brysonjk/o2_Analyzer/renders/battery_latch.png

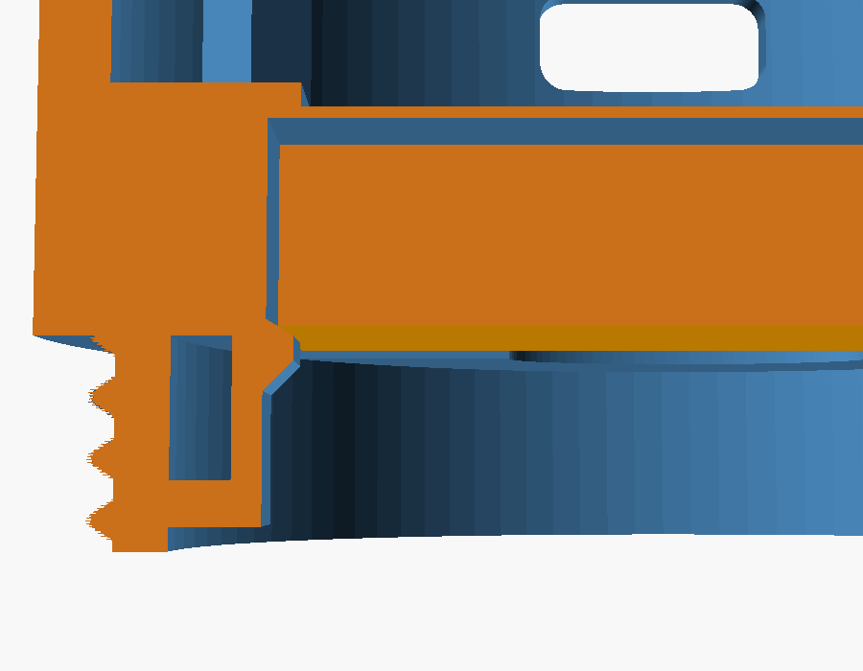
renders/battery_latch.png
