brysonjk/o2_Analyzer/renders/diverter.png

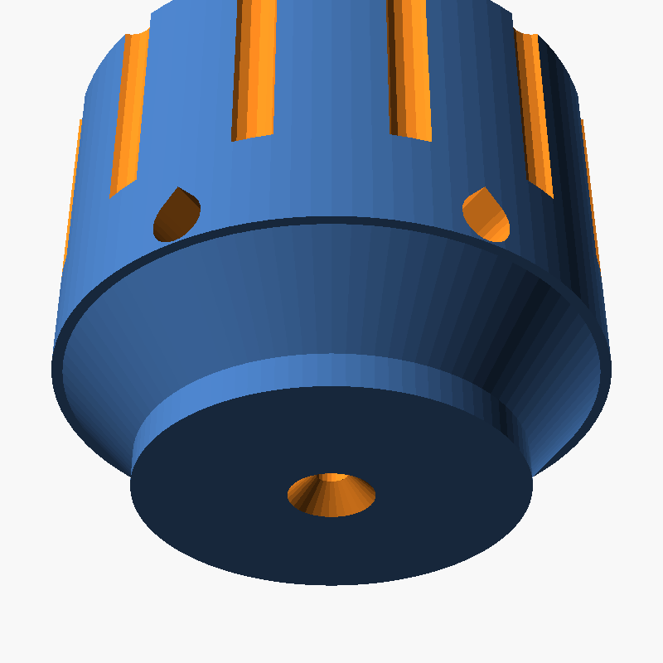
renders/diverter.png
