brysonjk/o2_Analyzer/renders/diverter_section.png

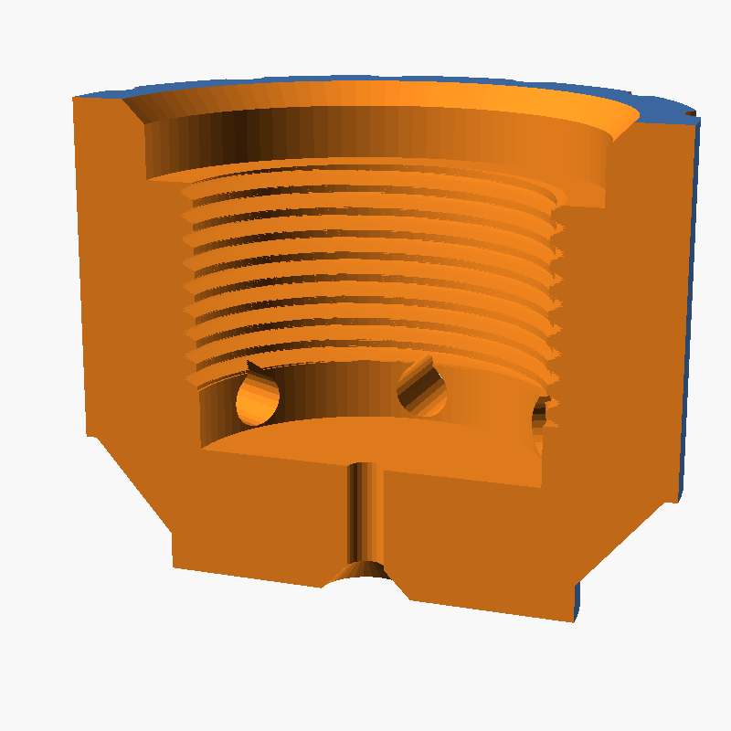
renders/diverter_section.png
