brysonjk/o2_Analyzer/renders/exploded.png

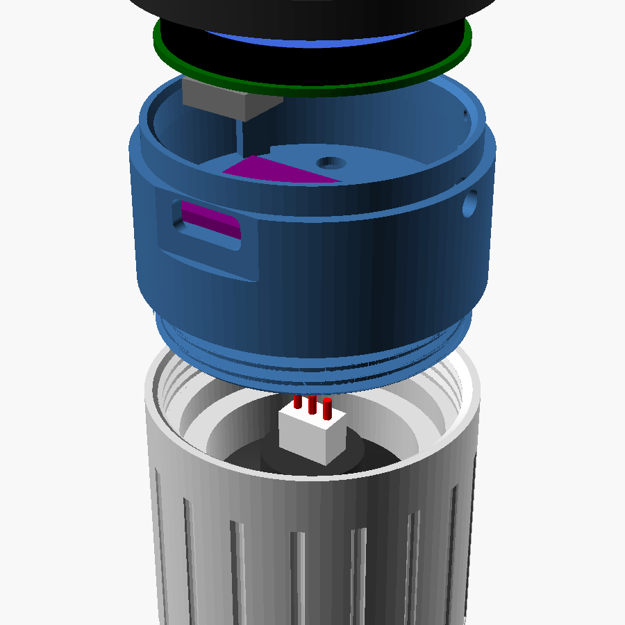
renders/exploded.png
