brysonjk/o2_Analyzer/renders/section.png

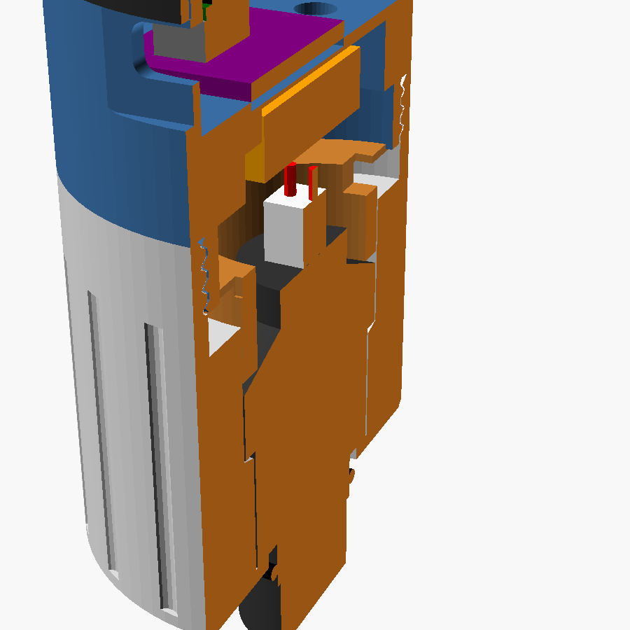
renders/section.png
