brysonjk/o2_Analyzer/stl/cap.stl

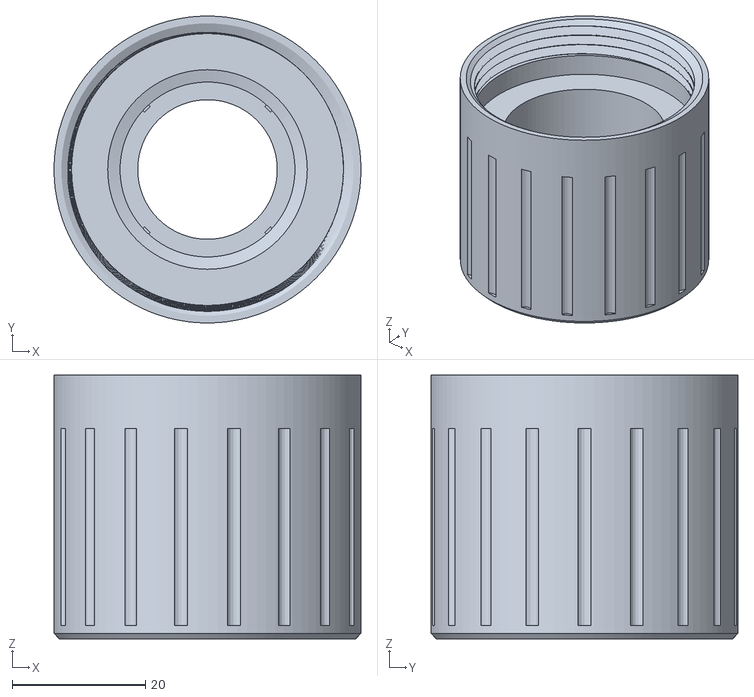
[picture p6: CAD file, 2026-10-21]
stl/cap.stl
46.0 x 46.0 x 39.5
