brysonjk/o2_Analyzer/viewer/m/diverter.stl

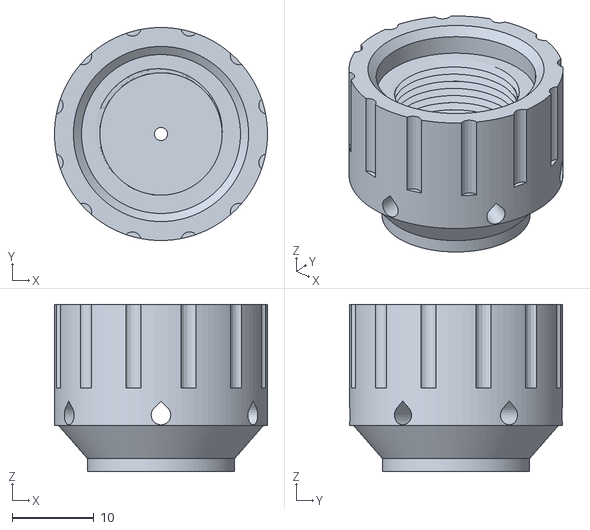
[picture p7: CAD file, 2026-10-21]
viewer/m/diverter.stl
26.0 x 26.0 x 20.4
