brysonjk/o2_Analyzer/stl/fit_test.stl

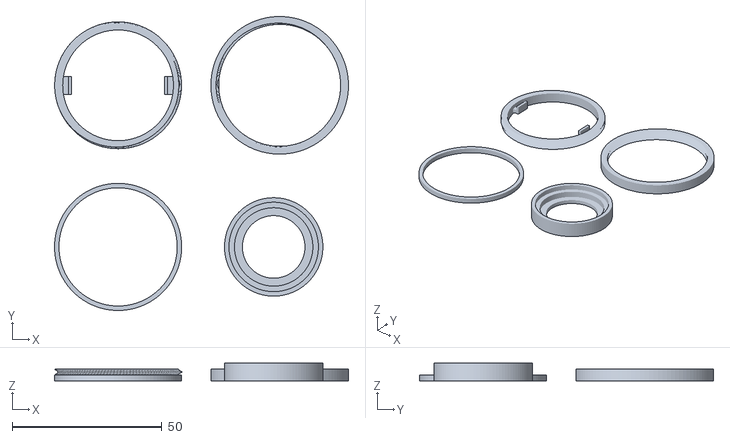
[picture p8: CAD file, 2026-10-21]
stl/fit_test.stl
98.2 x 98.2 x 6.00
