brysonjk/o2_Analyzer/stl/button.stl

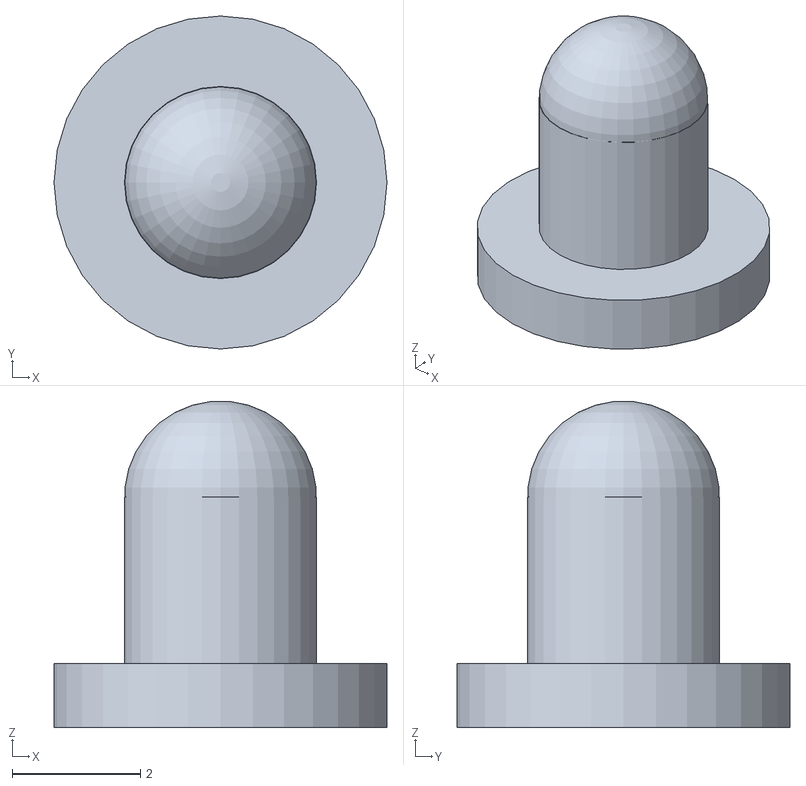
[picture p9: CAD file, 2026-10-21]
stl/button.stl
5.20 x 5.20 x 5.09
