brysonjk/o2_Analyzer/viewer/m/bezel.stl

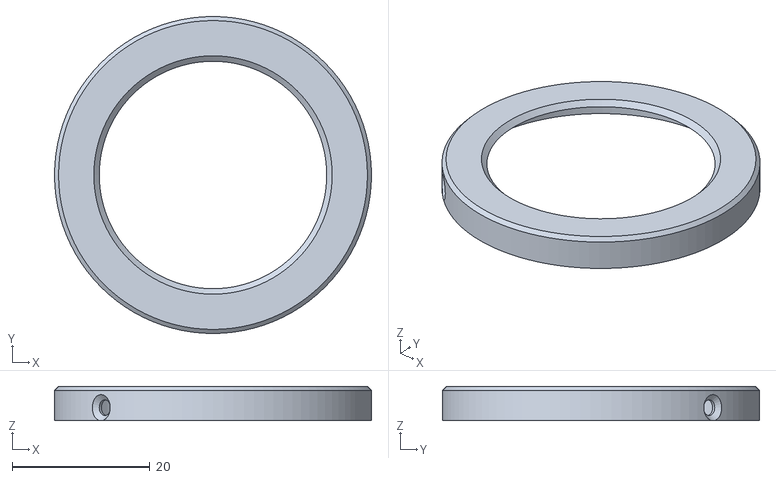
[picture p10: CAD file, 2026-10-21]
viewer/m/bezel.stl
46.0 x 46.0 x 5.00
