brysonjk/o2_Analyzer/viewer/m/body.stl

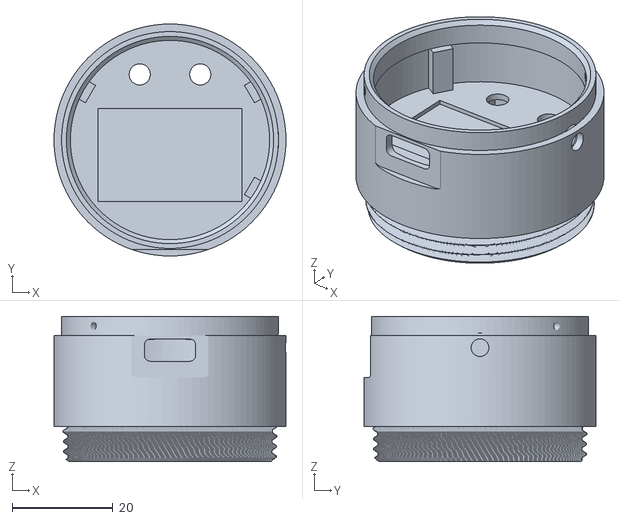
[picture p11: CAD file, 2026-10-21]
viewer/m/body.stl
46.0 x 46.0 x 28.8
