brysonjk/o2_Analyzer/viewer/m/display.stl

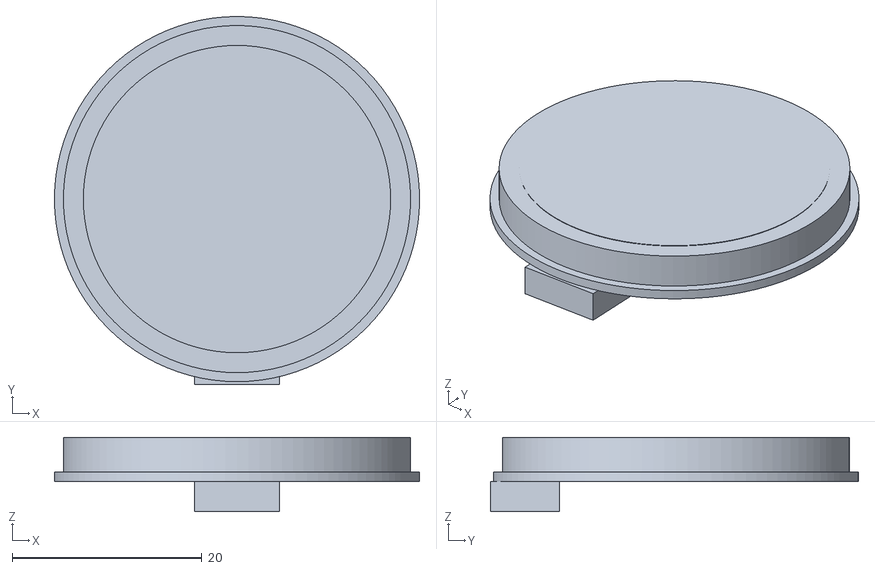
[picture p12: CAD file, 2026-10-21]
viewer/m/display.stl
38.5 x 38.8 x 7.85
