brysonjk/o2_Analyzer/stl/retainer.stl

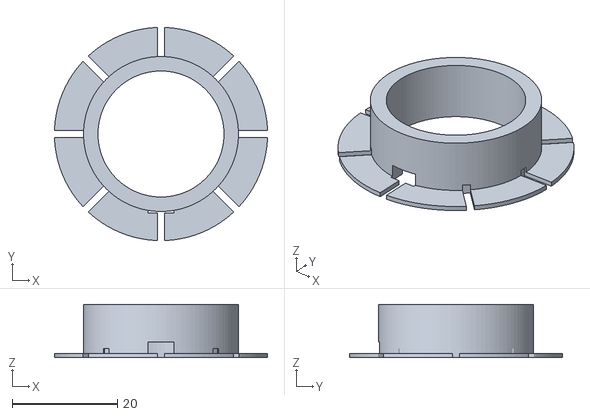
[picture p13: CAD file, 2026-10-21]
stl/retainer.stl
40.6 x 40.6 x 10.2
