brysonjk/o2_Analyzer/viewer/m/battery.stl

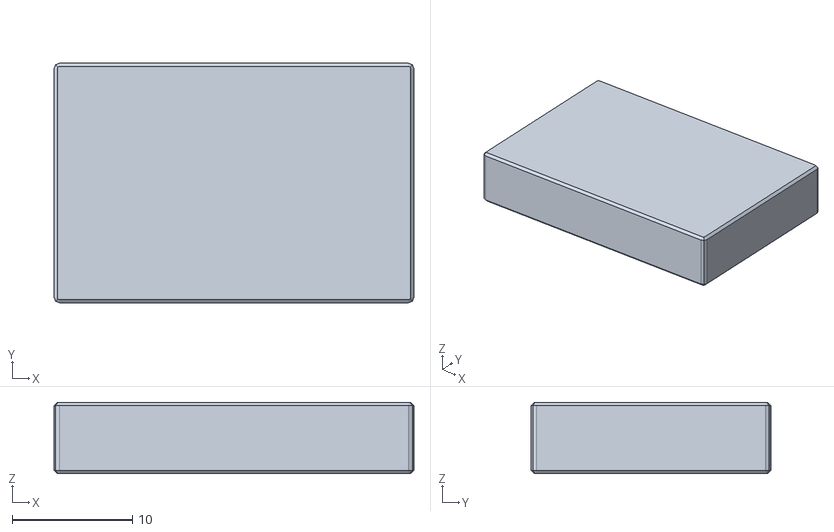
[picture p14: CAD file, 2026-10-21]
viewer/m/battery.stl
29.9 x 19.9 x 5.92
