brysonjk/o2_Analyzer/viewer/m/ads.stl

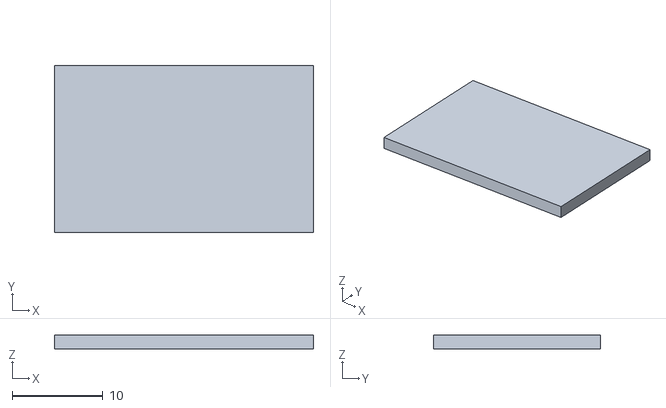
[picture p15: CAD file, 2026-10-21]
viewer/m/ads.stl
28.6 x 18.4 x 1.60
