brysonjk/o2_Analyzer/viewer/m/sensor.stl

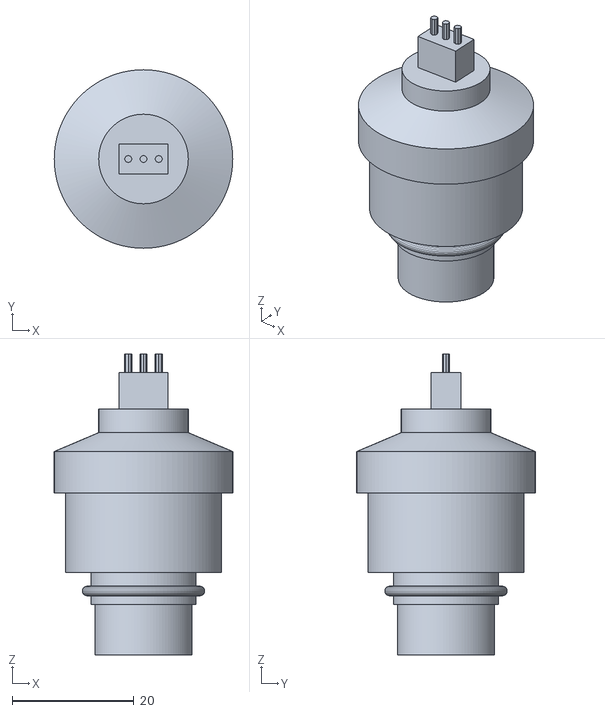
[picture p16: CAD file, 2026-10-21]
viewer/m/sensor.stl
29.3 x 29.3 x 49.4
