brysonjk/o2_Analyzer/(list of files, cad)

Other CAD files:
viewer/m/cap.stl
stl/bezel.stl
stl/diverter.stl
stl/body.stl
viewer/m/button.stl
viewer/m/retainer.stl
