brysonjk/o2_Analyzer/renders/assembly.png

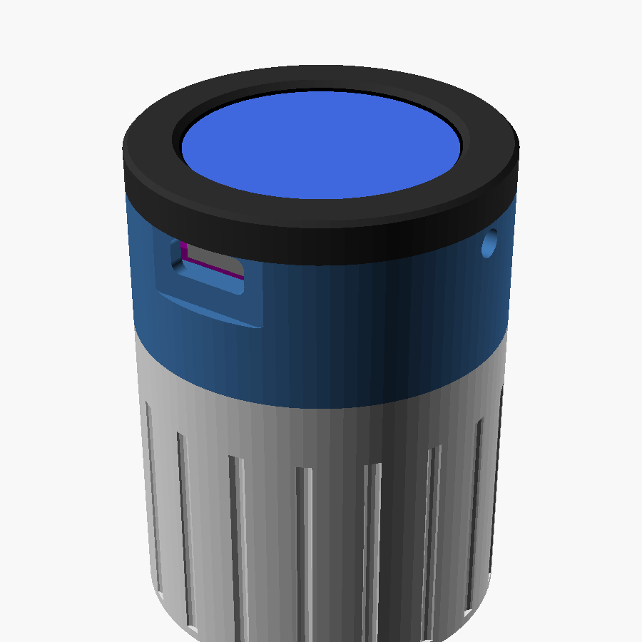
renders/assembly.png
