brysonjk/o2_Analyzer/(commit log)

2026-10-21 Initial commit: O2 analyzer enclosure, firmware, and viewer
    [ads.stl, battery.stl, bezel.stl, body.stl, button.stl, cap.stl, display.stl, diverter.scad]
2026-10-21 Add browser display simulator; fix 3D viewer STL loading
    The simulator ports drawScreen(), touch handling, calibration and the
    serial commands from O2_Analyzer.ino to JavaScript, driven by a simulated
    galvanic cell. The viewer requested base64 .txt files that don't exist;
    it now loads the .stl files directly.
